jaiswal-anurag/delta-sigma-adc-asic/matlab-simulink/DT/output_results_rtl.txt

    -1
     0
     1
     3
     6
     8
     9
     9
     7
     5
     0
    -4
   -13
    13
   386
  1324
  2619
  3952
  5003
  5491
  5219
  4100
  2174
  -395
 -3341
 -6324
 -8976
-10943
-11932
-11753
-10336
 -7756
 -4218
   -48
  4348
  8519
 12023
 14470
 15572
 15168
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
